g4belo/fmcw-radar-tracker/Hardware/FMCW_Radar/6_atuadores_potencia.kicad_sch

## KiCad design Hardware/FMCW_Radar/6_atuadores_potencia.kicad_sch (2026-10-08)

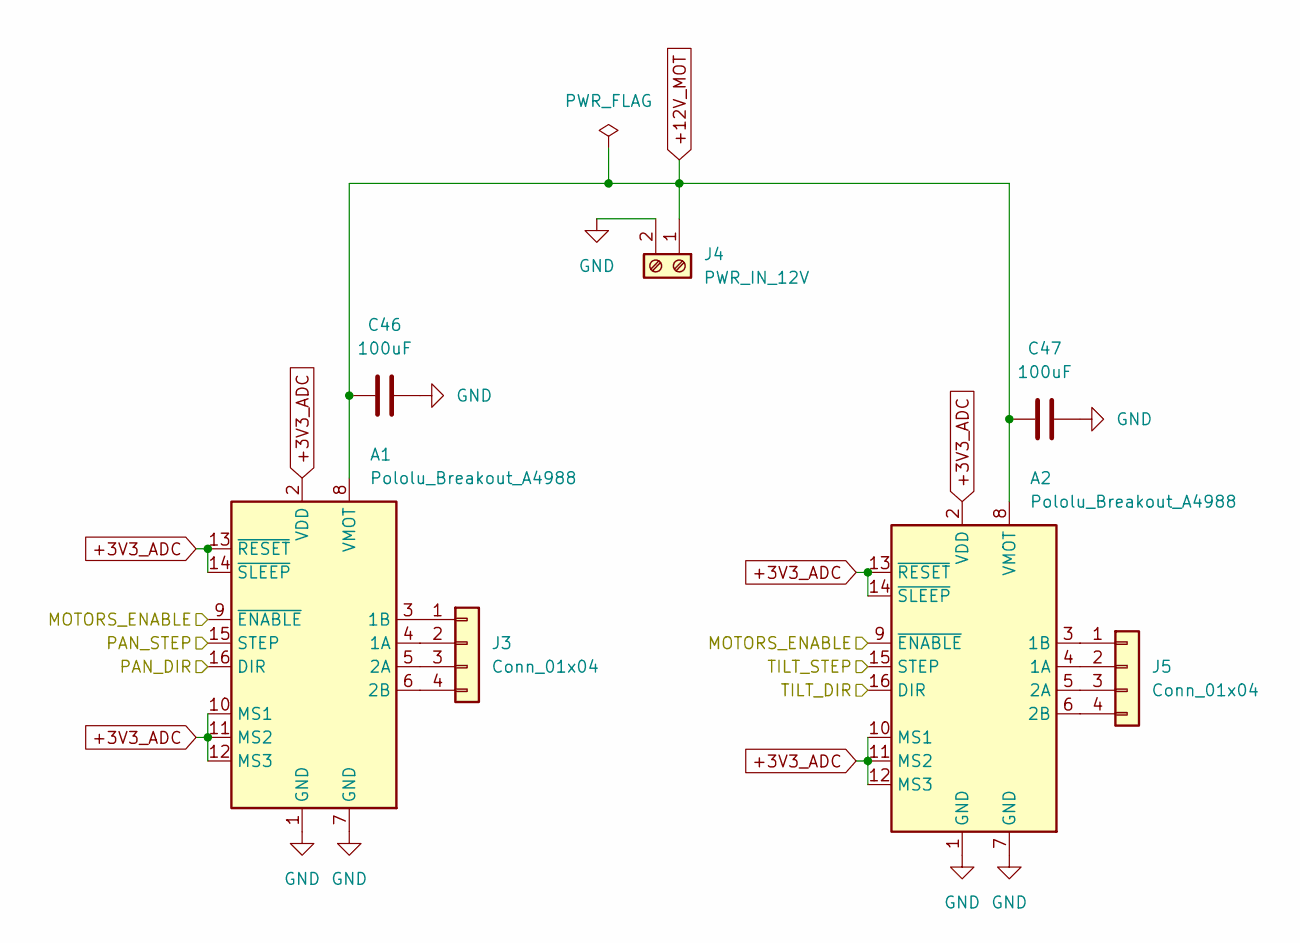
[picture p3: schematic 6_atuadores_potencia.kicad_sch]

Parts:
A1, A2: Pololu_Breakout_A4988; Pololu_Breakout-16_15.2x20.3mm
C46: 100uF; SOIC-8_3.9x4.9mm_P1.27mm
C47: 100uF
J3, J5: Conn_01x04
J4: PWR_IN_12V

Connections:
+3V3_ADC: A1.2 (VDD), A1.10 (MS1), A1.11 (MS2), A1.12 (MS3), A1.13 (~RESET), A1.14 (~SLEEP), A2.2 (VDD), A2.10 (MS1), A2.11 (MS2), A2.12 (MS3), A2.13 (~RESET), A2.14 (~SLEEP)
+12V_MOT: A1.8 (VMOT), A2.8 (VMOT), C46.1, C47.1, J4.1
GND: A1.1 (GND), A1.7 (GND), A2.1 (GND), A2.7 (GND), C46.2, C47.2, J4.2
MOTORS_ENABLE: A1.9 (~ENABLE), A2.9 (~ENABLE)
unnamed: A1.3 (1B), J3.1
unnamed: A1.4 (1A), J3.2
unnamed: A1.5 (2A), J3.3
unnamed: A1.6 (2B), J3.4
unnamed: A2.3 (1B), J5.1
unnamed: A2.4 (1A), J5.2
unnamed: A2.5 (2A), J5.3
unnamed: A2.6 (2B), J5.4
PAN_DIR: A1.16 (DIR)
PAN_STEP: A1.15 (STEP)
TILT_DIR: A2.16 (DIR)
TILT_STEP: A2.15 (STEP)
