g4belo/fmcw-radar-tracker/Hardware/FMCW_Radar/alimentacao.kicad_sch

## KiCad design Hardware/FMCW_Radar/alimentacao.kicad_sch (2026-10-08)

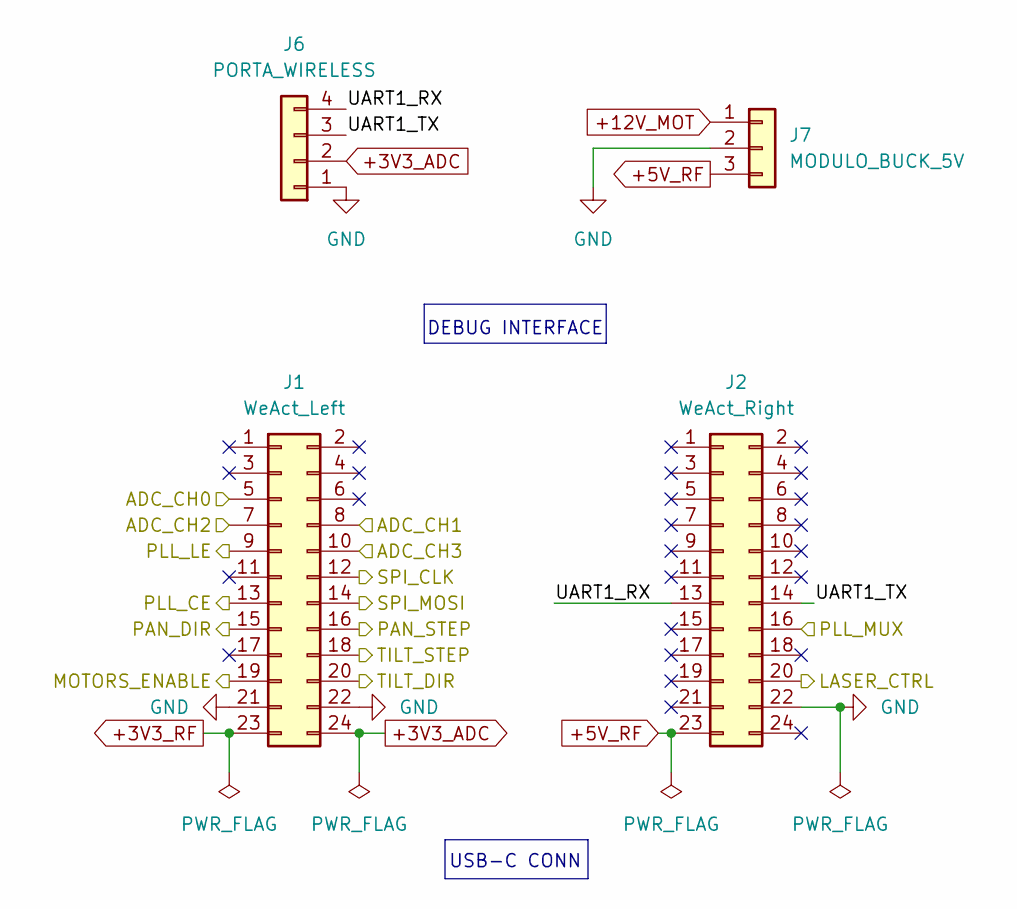
[picture p4: schematic alimentacao.kicad_sch]

Parts:
J1: WeAct_Left
J2: WeAct_Right
J6: PORTA_WIRELESS
J7: MODULO_BUCK_5V

Connections:
+3V3_ADC: J1.24, J6.2
+3V3_RF: J1.23
+5V_RF: J2.23, J7.3
+12V_MOT: J7.1
ADC_CH0: J1.5
ADC_CH1: J1.8
ADC_CH2: J1.7
ADC_CH3: J1.10
GND: J1.21, J1.22, J2.22, J6.1, J7.2
LASER_CTRL: J2.20
MOTORS_ENABLE: J1.19
PAN_DIR: J1.15
PAN_STEP: J1.16
PLL_CE: J1.13
PLL_LE: J1.9
PLL_MUX: J2.16
SPI_CLK: J1.12
SPI_MOSI: J1.14
TILT_DIR: J1.20
TILT_STEP: J1.18
UART1_RX: J2.13, J6.4
UART1_TX: J2.14, J6.3

Notes on the sheet:
USB-C CONN
DEBUG INTERFACE
