g4belo/fmcw-radar-tracker/Hardware/FMCW_Radar/baseband.kicad_sch

## KiCad design Hardware/FMCW_Radar/baseband.kicad_sch (2026-10-08)

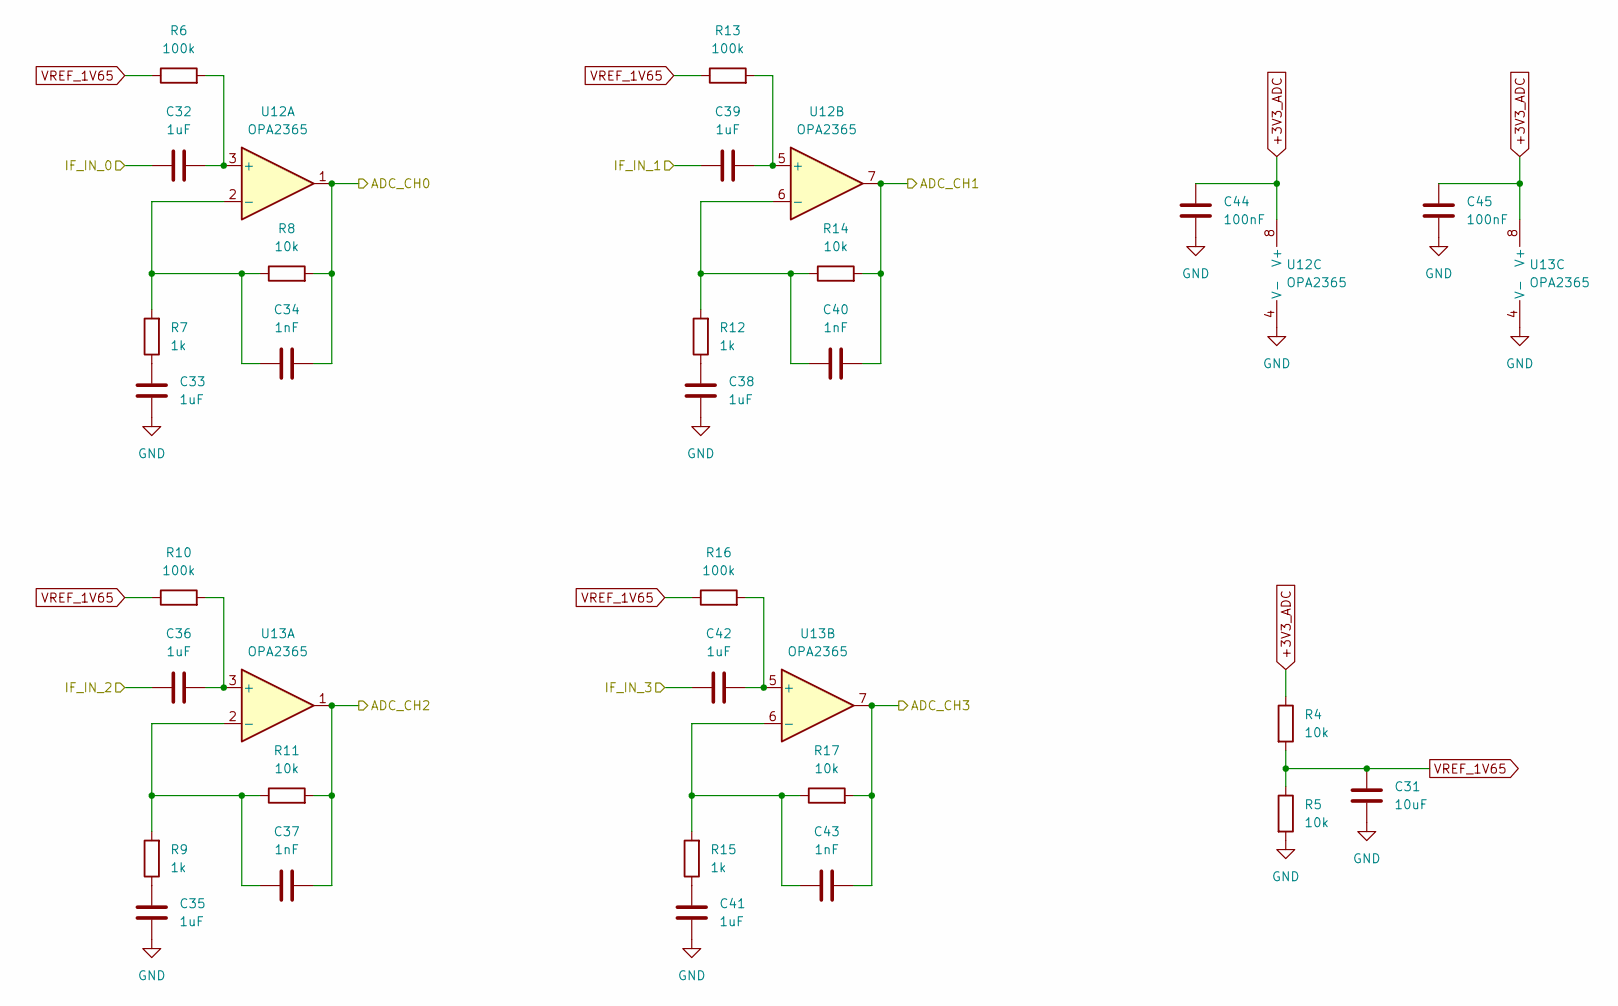
[picture p5: schematic baseband.kicad_sch]

Parts:
C31: 10uF
C32, C33, C35, C36, C38, C39, C41, C42: 1uF; SOIC-8_3.9x4.9mm_P1.27mm
C34, C37, C40, C43: 1nF; SOIC-8_3.9x4.9mm_P1.27mm
C44: 100nF; SOIC-8_3.9x4.9mm_P1.27mm
C45: 100nF
R4, R5, R8, R11, R14, R17: 10k; LQFP-100_14x14mm_P0.5mm
R6, R10, R13, R16: 100k; LQFP-100_14x14mm_P0.5mm
R7, R9, R12, R15: 1k; LQFP-100_14x14mm_P0.5mm
U12, U13: OPA2365; SOIC-8_3.9x4.9mm_P1.27mm

Connections:
+3V3_ADC: C44.1, C45.1, R4.1, U12.8 (V+), U13.8 (V+)
ADC_CH0: C34.2, R8.2, U12.1
ADC_CH1: C40.2, R14.2, U12.7
ADC_CH2: C37.2, R11.2, U13.1
ADC_CH3: C43.2, R17.2, U13.7
GND: C31.2, C33.1, C35.1, C38.1, C41.1, C44.2, C45.2, R5.2, U12.4 (V-), U13.4 (V-)
IF_IN_0: C32.1
IF_IN_1: C39.1
IF_IN_2: C36.1
IF_IN_3: C42.1
unnamed: C32.2, R6.2, U12.3 (+)
unnamed: C33.2, R7.1
unnamed: C34.1, R7.2, R8.1, U12.2 (-)
unnamed: C35.2, R9.1
unnamed: C36.2, R10.2, U13.3 (+)
unnamed: C37.1, R9.2, R11.1, U13.2 (-)
unnamed: C38.2, R12.1
unnamed: C39.2, R13.2, U12.5 (+)
unnamed: C40.1, R12.2, R14.1, U12.6 (-)
unnamed: C41.2, R15.1
unnamed: C42.2, R16.2, U13.5 (+)
unnamed: C43.1, R15.2, R17.1, U13.6 (-)
VREF_1V65: C31.1, R4.2, R5.1, R6.1, R10.1, R13.1, R16.1
