g4belo/fmcw-radar-tracker/Hardware/FMCW_Radar/recepcao.kicad_sch

## KiCad design Hardware/FMCW_Radar/recepcao.kicad_sch (2026-10-08)

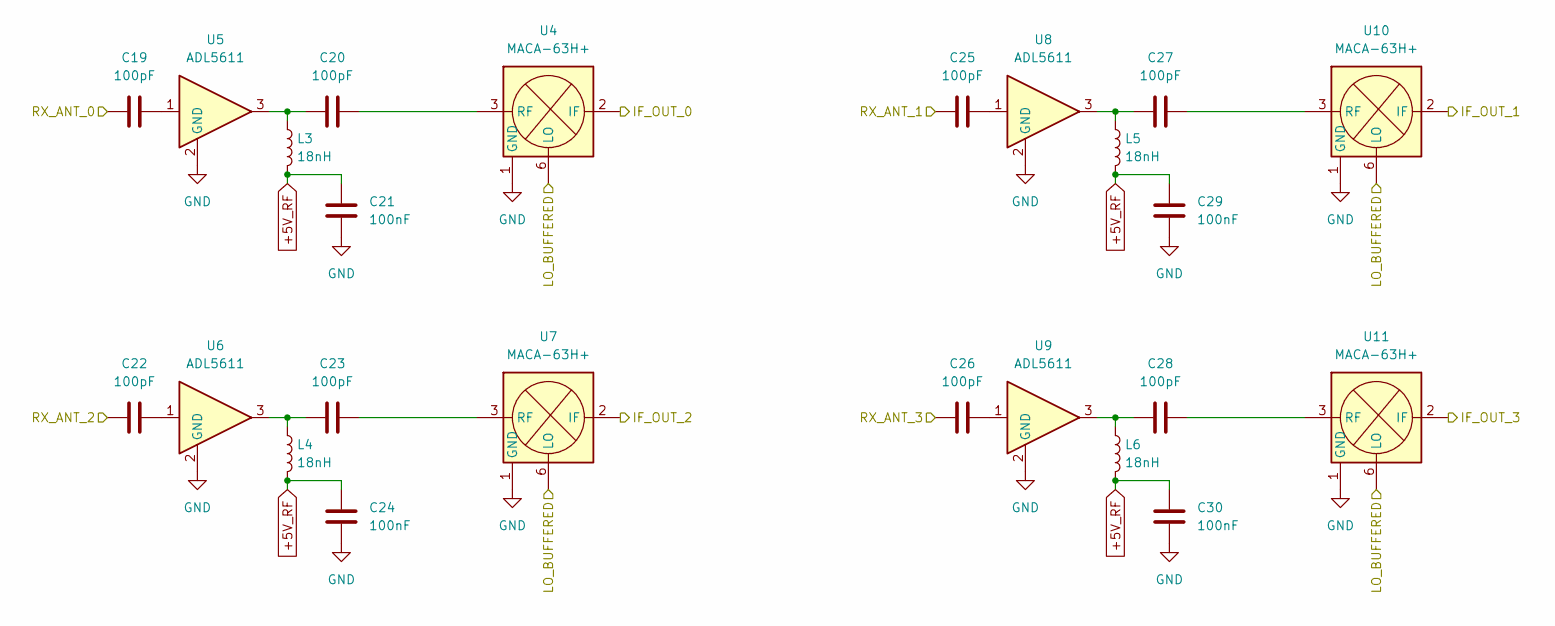
[picture p6: schematic recepcao.kicad_sch]

Parts:
C19, C20, C22, C23, C25, C26, C27, C28: 100pF
C21, C24, C29, C30: 100nF
L3, L4, L5, L6: 18nH
U4, U7, U10, U11: MACA-63H+; Mini-Circuits_CD542_LandPatternPL-052
U5, U6, U8, U9: ADL5611; SOT-89-3

Connections:
+5V_RF: C21.1, C24.1, C29.1, C30.1, L3.2, L4.2, L5.2, L6.2
GND: C21.2, C24.2, C29.2, C30.2, U4.1 (GND), U4.4 (GND), U4.5 (GND), U5.2 (GND), U6.2 (GND), U7.1 (GND), U7.4 (GND), U7.5 (GND), U8.2 (GND), U9.2 (GND), U10.1 (GND), U10.4 (GND), U10.5 (GND), U11.1 (GND), U11.4 (GND), U11.5 (GND)
IF_OUT_0: U4.2 (IF)
IF_OUT_1: U10.2 (IF)
IF_OUT_2: U7.2 (IF)
IF_OUT_3: U11.2 (IF)
LO_BUFFERED: U4.6 (LO), U7.6 (LO), U10.6 (LO), U11.6 (LO)
unnamed: C19.2, U5.1
unnamed: C20.1, L3.1, U5.3
unnamed: C20.2, U4.3 (RF)
unnamed: C22.2, U6.1
unnamed: C23.1, L4.1, U6.3
unnamed: C23.2, U7.3 (RF)
unnamed: C25.2, U8.1
unnamed: C26.2, U9.1
unnamed: C27.1, L5.1, U8.3
unnamed: C27.2, U10.3 (RF)
unnamed: C28.1, L6.1, U9.3
unnamed: C28.2, U11.3 (RF)
RX_ANT_0: C19.1
RX_ANT_1: C25.1
RX_ANT_2: C22.1
RX_ANT_3: C26.1
