g4belo/fmcw-radar-tracker/Hardware/FMCW_Radar/sintetizador.kicad_sch

## KiCad design Hardware/FMCW_Radar/sintetizador.kicad_sch (2026-10-08)

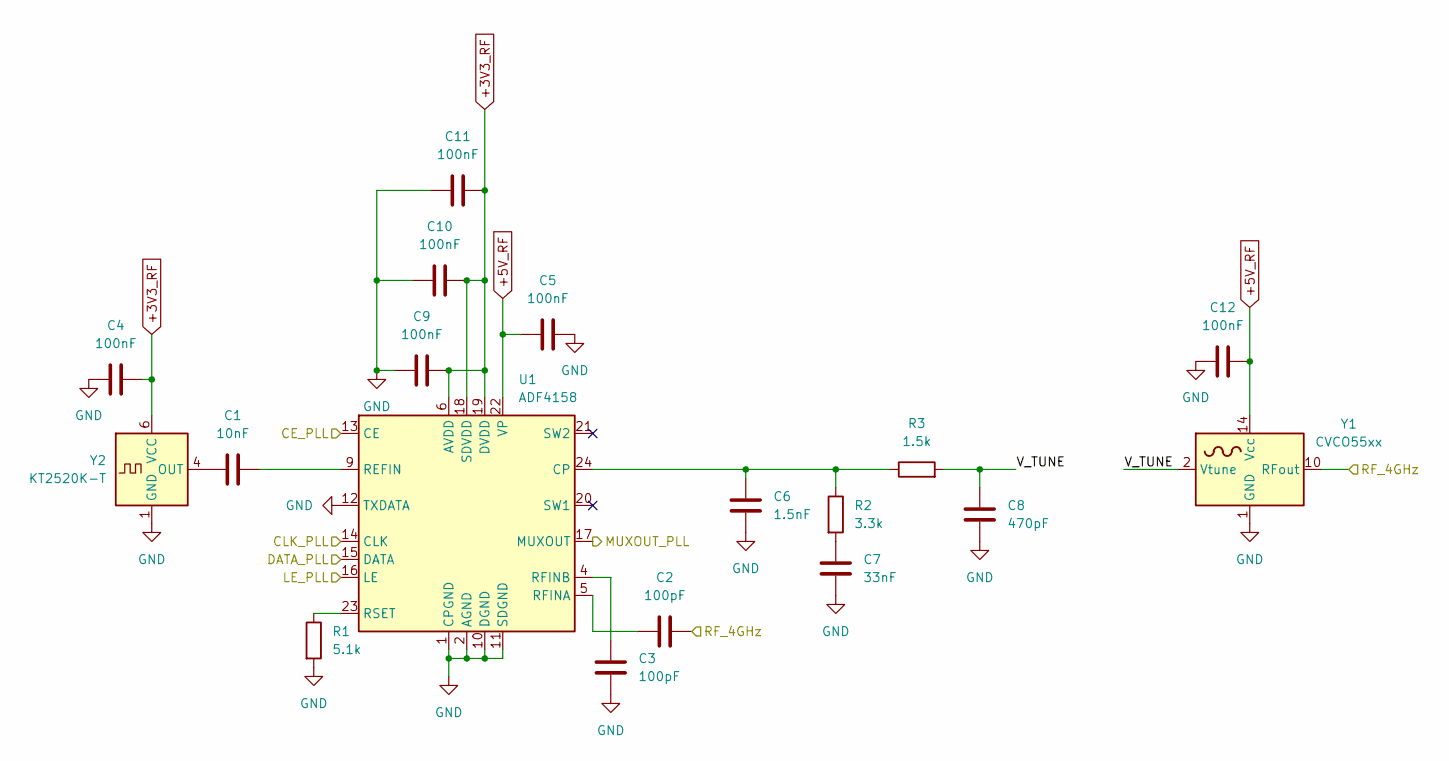
[picture p7: schematic sintetizador.kicad_sch]

Parts:
C1: 10nF; Oscillator_SMD_Kyocera_2520-6Pin_2.5x2.0mm
C2, C3: 100pF; Oscillator_SMD_Kyocera_2520-6Pin_2.5x2.0mm
C4, C5, C9, C10, C11, C12: 100nF; Oscillator_SMD_Kyocera_2520-6Pin_2.5x2.0mm
C6: 1.5nF; Oscillator_SMD_Kyocera_2520-6Pin_2.5x2.0mm
C7: 33nF; Oscillator_SMD_Kyocera_2520-6Pin_2.5x2.0mm
C8: 470pF; Oscillator_SMD_Kyocera_2520-6Pin_2.5x2.0mm
R1: 5.1k
R2: 3.3k
R3: 1.5k
U1: ADF4158; LFCSP-24-1EP_4x4mm_P0.5mm_EP2.5x2.5mm
Y1: CVCO55xx; Mini-Circuits_CK605_LandPatternPL-012
Y2: KT2520K-T; Oscillator_SMD_Kyocera_2520-6Pin_2.5x2.0mm

Connections:
+3V3_RF: C4.2, C9.2, C10.2, C11.2, U1.6 (AVDD), U1.7 (AVDD), U1.8 (AVDD), U1.18 (SDVDD), U1.19 (DVDD), Y2.6 (VCC)
+5V_RF: C5.1, C12.2, U1.22 (VP), Y1.14 (Vcc)
CE_PLL: U1.13 (CE)
CLK_PLL: U1.14 (CLK)
DATA_PLL: U1.15 (DATA)
GND: C3.1, C4.1, C5.2, C6.1, C7.1, C8.2, C9.1, C10.1, C11.1, C12.1, R1.2, U1.1 (CPGND), U1.2 (AGND), U1.3 (AGND), U1.10 (DGND), U1.11 (SDGND), U1.12 (TXDATA), U1.25 (AGND), Y1.1 (GND), Y1.3 (GND), Y1.4 (GND), Y1.5 (GND), Y1.6 (GND), Y1.7 (GND), Y1.8 (GND), Y1.9 (GND), Y1.11 (GND), Y1.12 (GND), Y1.13 (GND), Y1.15 (GND), Y1.16 (GND), Y2.1 (GND), Y2.3 (GND)
LE_PLL: U1.16 (LE)
MUXOUT_PLL: U1.17 (MUXOUT)
unnamed: C1.1, Y2.4 (OUT)
unnamed: C1.2, U1.9 (REFIN)
unnamed: C2.1, U1.5 (RFINA)
unnamed: C3.2, U1.4 (RFINB)
unnamed: C6.2, R2.1, R3.1, U1.24 (CP)
unnamed: C7.2, R2.2
unnamed: R1.1, U1.23 (RSET)
RF_4GHz: C2.2, Y1.10 (RFout)
V_TUNE: C8.1, R3.2, Y1.2 (Vtune)
