g4belo/fmcw-radar-tracker/Hardware/FMCW_Radar/transmissao.kicad_sch

## KiCad design Hardware/FMCW_Radar/transmissao.kicad_sch (2026-10-08)

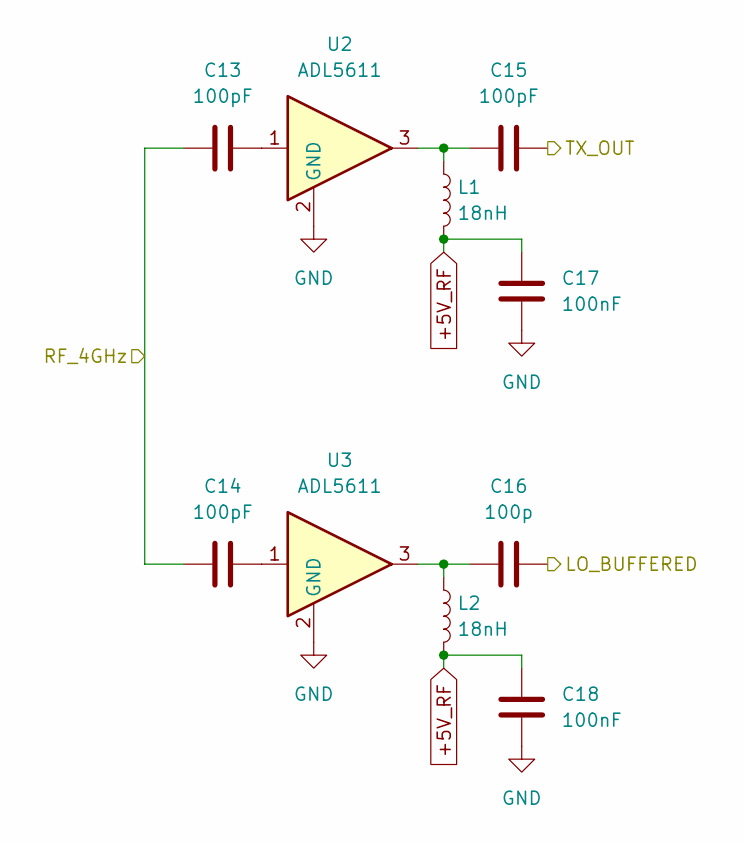
[picture p8: schematic transmissao.kicad_sch]

Parts:
C13, C14, C15: 100pF
C16: 100p
C17, C18: 100nF
L1, L2: 18nH
U2, U3: ADL5611; SOT-89-3

Connections:
+5V_RF: C17.1, C18.1, L1.2, L2.2
GND: C17.2, C18.2, U2.2 (GND), U3.2 (GND)
LO_BUFFERED: C16.2
unnamed: C13.2, U2.1
unnamed: C14.2, U3.1
unnamed: C15.1, L1.1, U2.3
unnamed: C16.1, L2.1, U3.3
RF_4GHz: C13.1, C14.1
TX_OUT: C15.2
