g4belo/fmcw-radar-tracker/Firmware/FMCW_Radar_Core/FMCW_Radar_Core.ioc

Mcu.UserName=STM32G474CEUx
PA0.Signal=ADC1_IN1
PA10.Signal=USART1_RX
PA11.Signal=USB_DM
PA12.Signal=USB_DP
PA13.Signal=SYS_JTMS-SWDIO
PA14.Signal=SYS_JTCK-SWCLK
PA2.Signal=USART2_TX
PA3.Signal=USART2_RX
PA4.Signal=ADC2_IN17
PA9.Signal=USART1_TX
PB0.GPIO_Label=PAN_STEP
PB0.Signal=GPIO_Output
PB1.GPIO_Label=PAN_DIR
PB1.Signal=GPIO_Output
PB10.GPIO_Label=TILT_DIR
PB10.Signal=GPIO_Output
PB12.GPIO_Label=LASER_CTRL
PB12.Signal=GPIO_Output
PB13.Signal=ADC3_IN5
PB14.Signal=ADC4_IN4
PB2.GPIO_Label=TILT_STEP
PB2.Signal=GPIO_Output
PF0-OSC_IN.Signal=RCC_OSC_IN
PF1-OSC_OUT.Signal=RCC_OSC_OUT
