g4belo/fmcw-radar-tracker/Firmware/FMCW_Radar_Core/Core/Inc/main.h

#define PAN_STEP_Pin GPIO_PIN_0
#define PAN_STEP_GPIO_Port GPIOB
#define PAN_DIR_Pin GPIO_PIN_1
#define PAN_DIR_GPIO_Port GPIOB
#define TILT_STEP_Pin GPIO_PIN_2
#define TILT_STEP_GPIO_Port GPIOB
#define TILT_DIR_Pin GPIO_PIN_10
#define TILT_DIR_GPIO_Port GPIOB
#define LASER_CTRL_Pin GPIO_PIN_12
#define LASER_CTRL_GPIO_Port GPIOB
