g4belo/fmcw-radar-tracker/Firmware/FMCW_Radar_Core/Core/Inc/app_main.h

/*
 * app_main.h
 *
 *  Created on: Sep 29, 2026
 *      Author: gh0st
 */

#ifndef INC_APP_MAIN_H_
#define INC_APP_MAIN_H_


#ifdef __cplusplus
extern "C" {
#endif

/* Ponto de entrada da aplicação C++ chamado a partir do main.c */
void app_main(void);

#ifdef __cplusplus
}
#endif


#endif /* INC_APP_MAIN_H_ */
