g4belo/fmcw-radar-tracker/(notices)

Notices in the files:
Firmware/FMCW_Radar_Core/Core/Inc/main.h:
Copyright (c) 2026 STMicroelectronics.
All rights reserved.
This software is licensed under terms that can be found in the LICENSE file
